TSYP14Challenges/RASxAESSxChallenge/computer_vision/README.md

# Computer vision

**Owner:** Bacha
**Status:** not started

Camera images in, `(event_type, event_value)` out. The Writer puts that pair
in the EVENT_BEACON it drops (see
[`docs/protocol/frame-format.md`](../docs/protocol/frame-format.md)).
