TSYP14Challenges/RASxAESSxChallenge/mechanical-design/3D/design-files/README.md

# Design files

Editable CAD sources (.f3d, .step, .FCStd, .sldprt, …). Export print-ready
files to [`../print-files/`](../print-files/) with the same base name.
