TSYP14Challenges/RASxAESSxChallenge/docs/report/sections/06-robots-hardware.tex

% Owners: Bacha (tank approach, 2FW drive), Hachicha (navigation, BMS and battery)
\section{Robot Hardware}
\todo{components of each robot}
