TSYP14Challenges/RASxAESSxChallenge/docs/report/sections/08-frame-translation.tex

% Owner: Bacha
\section{Frame Translation}\label{sec:frame-translation}
\todo{coordinate system (encoders and SLAM), origin at the PEB, math}
