TSYP14Challenges/RASxAESSxChallenge/docs/report/sections/12-implementation.tex

% Owner: Bacha
\section{Implementation Plan}
\todo{scrum, sprints (add LEDs for beacons)}
