TSYP14Challenges/RASxAESSxChallenge/docs/report/sections/07-navigation.tex

% Owners: Hachicha (writer navigation, executor entry and navigation), Bacha (event detection, executor types, mission decision)
\section{Navigation}
\subsection{Writer}
\todo{navigation (LiDAR, ...) --- Hachicha}

\todo{event detection (hardware, types) --- Bacha}
\subsection{Executor}
\todo{types of executors and how each solves an event --- Bacha}

\todo{mission decision --- Bacha}

\todo{entry and navigation: follows beacon drop order, and why --- Hachicha}
