TSYP14Challenges/RASxAESSxChallenge/mechanical-design/3D/design-files/Assembly/robot assembly 1.SLDASM

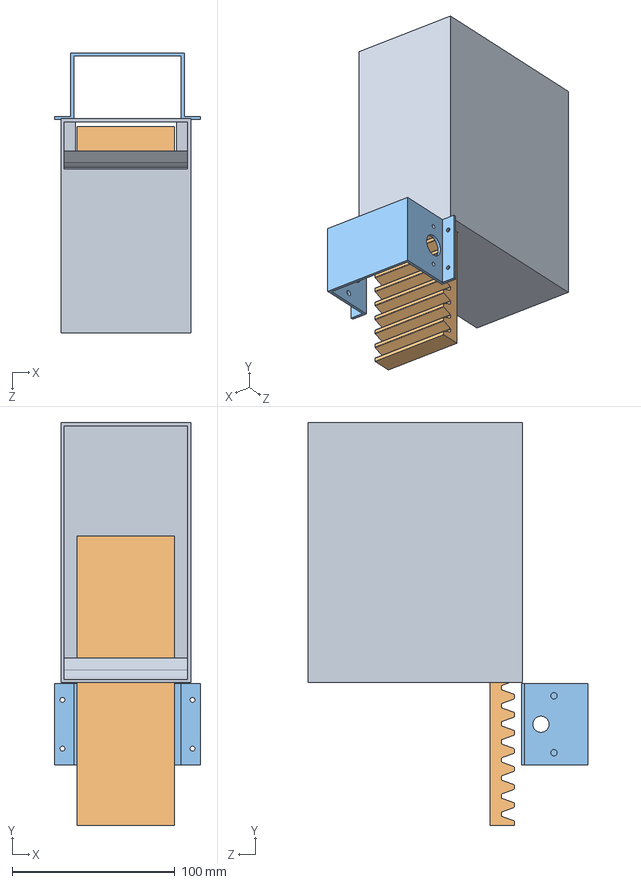
[picture p2: CAD file, 2026-10-05]
mechanical-design/3D/design-files/Assembly/robot assembly 1.SLDASM
90.0 x 247.9 x 172.4 mm
support stepper
Racks
beacons stack
