TSYP14Challenges/RASxAESSxChallenge/mechanical-design/3D/print-files/Parts/robot_main_body.STL

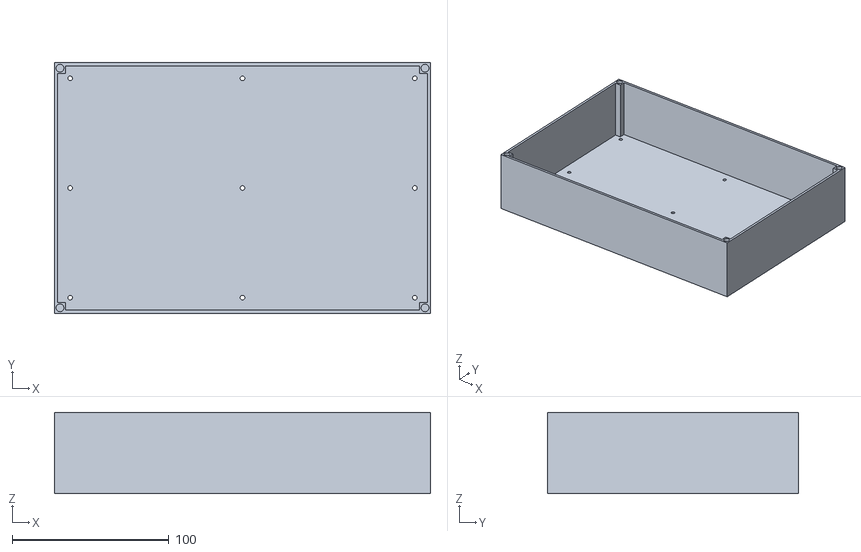
[picture p3: CAD file, 2026-10-05]
mechanical-design/3D/print-files/Parts/robot_main_body.STL
240.0 x 160.0 x 52.0
