TSYP14Challenges/RASxAESSxChallenge/mechanical-design/3D/design-files/Assembly/robot assembly 2.SLDASM

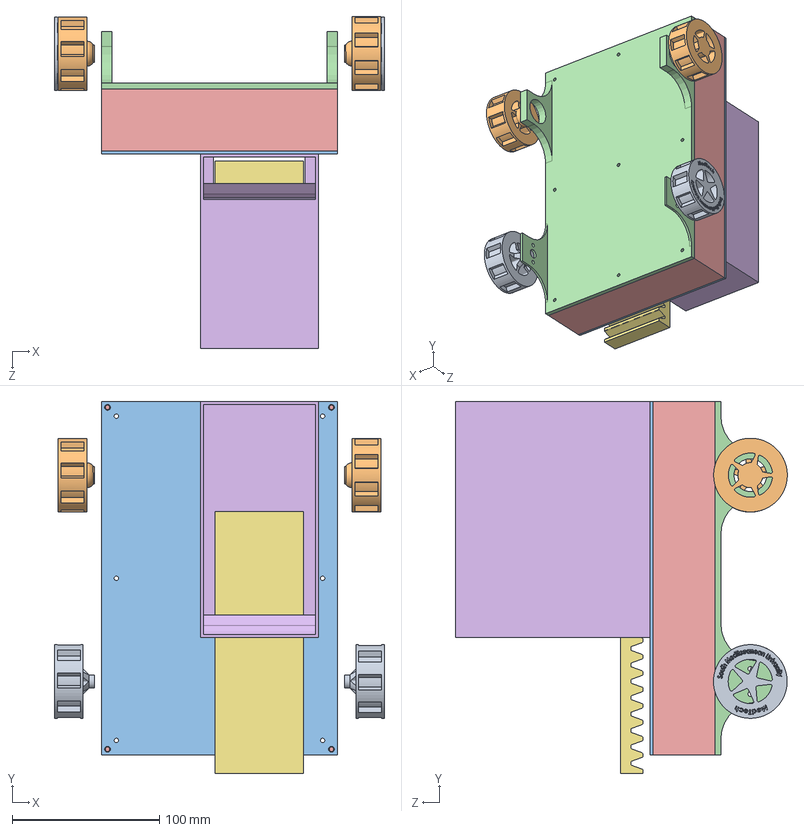
[picture p4: CAD file, 2026-10-05]
mechanical-design/3D/design-files/Assembly/robot assembly 2.SLDASM
224.0 x 252.5 x 225.1 mm
support stepper
Racks
beacons stack
robot level1 base
robot_base
robot level1 cover
Wheel_axe x 2
Wheel x 2
