TSYP14Challenges/RASxAESSxChallenge/mechanical-design/3D/design-files/Parts/robot level1 cover.SLDPRT

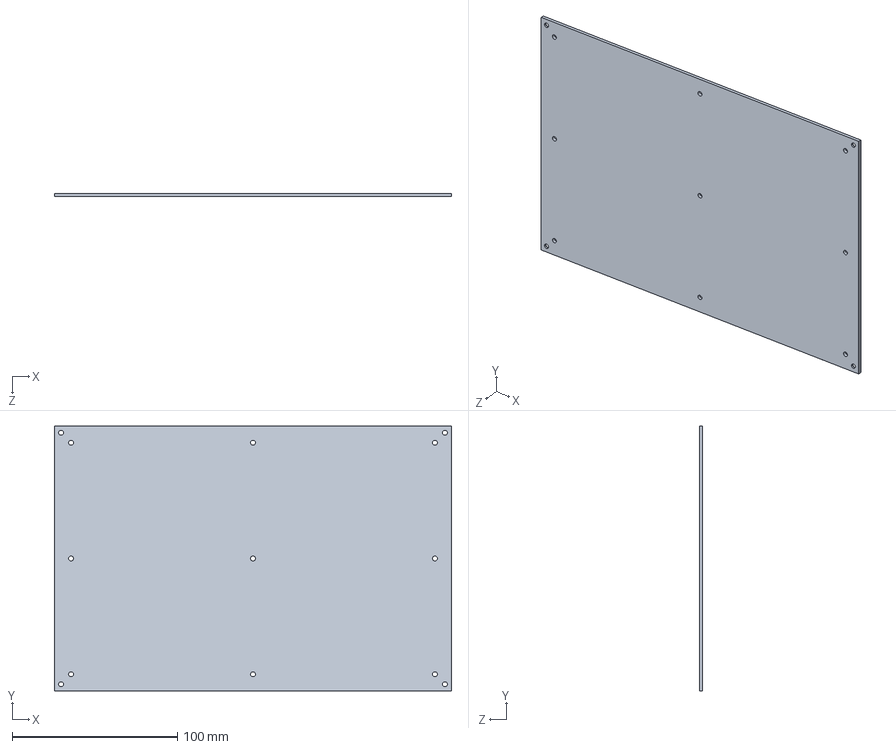
[picture p5: CAD file, 2026-10-05]
mechanical-design/3D/design-files/Parts/robot level1 cover.SLDPRT
240.0 x 160.0 x 2.00 mm
