TSYP14Challenges/RASxAESSxChallenge/mechanical-design/3D/print-files/Print Plate/print_plate_with_spport.3mf

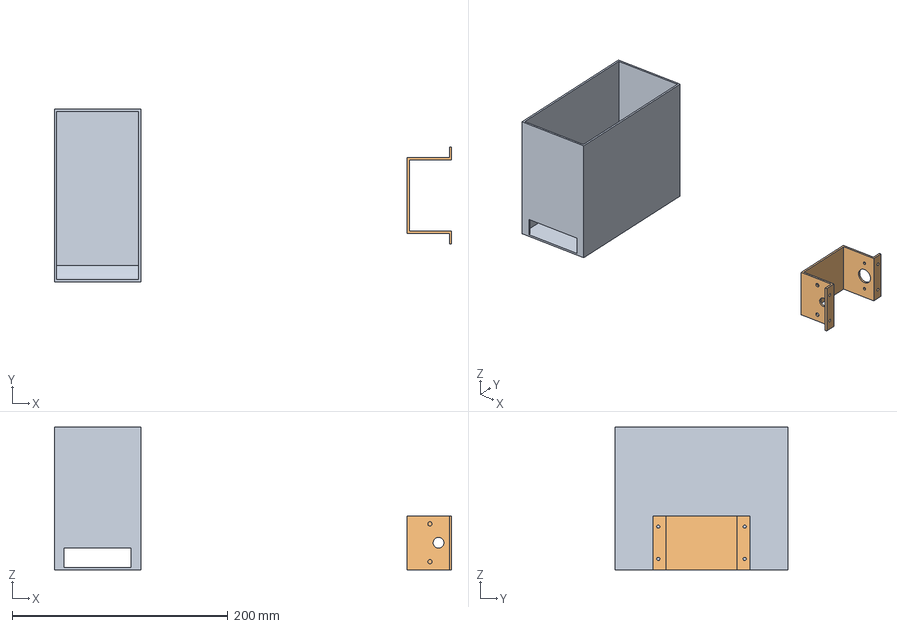
[picture p6: CAD file, 2026-10-05]
mechanical-design/3D/print-files/Print Plate/print_plate_with_spport.3mf
367.7 x 160.0 x 132.0 mm
beacons stack.STL
support stepper.STL
