TSYP14Challenges/RASxAESSxChallenge/mechanical-design/3D/design-files/Parts/back wheels axe.SLDPRT

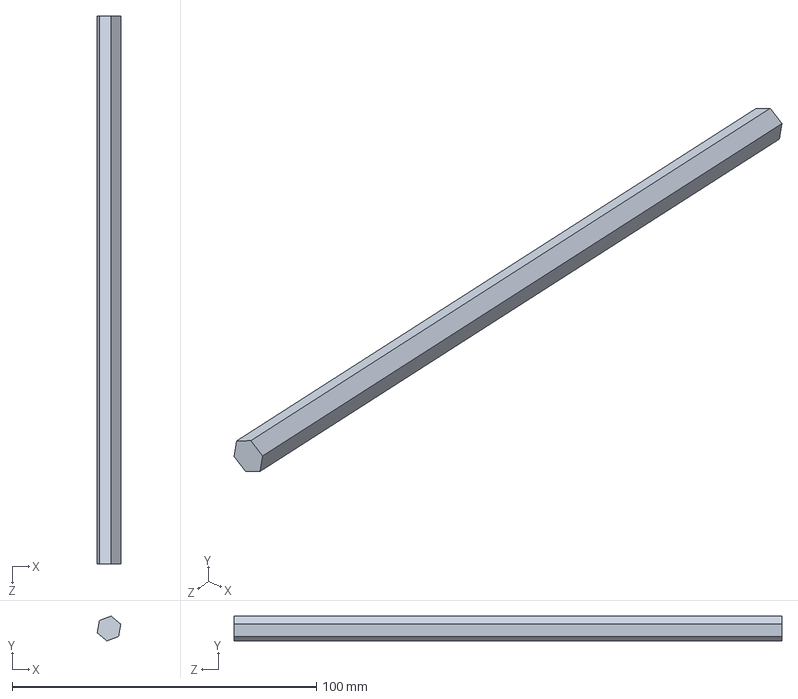
[picture p7: CAD file, 2026-10-05]
mechanical-design/3D/design-files/Parts/back wheels axe.SLDPRT
7.74 x 8.14 x 180.0 mm
