TSYP14Challenges/RASxAESSxChallenge/mechanical-design/3D/print-files/Print Plate/print_plate_without_spport.3mf

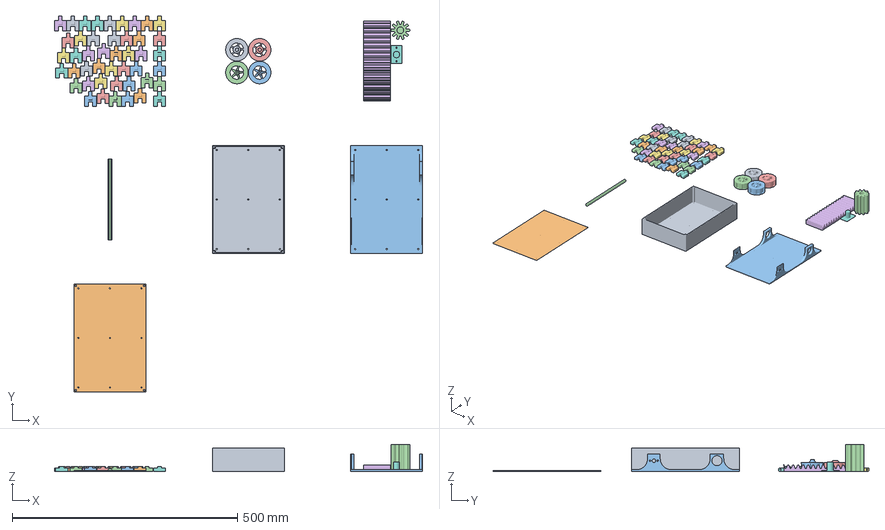
[picture p8: CAD file, 2026-10-05]
mechanical-design/3D/print-files/Print Plate/print_plate_without_spport.3mf
817.9 x 834.6 x 60.0 mm
robot_main_body.STL
robot level1 cover.STL
robot_base.STL
GEAR 2.STL
Wheel_axe.STL x 2
Racks.STL
chenille.stl x 45
axe for gear.STL
Wheel.STL x 2
axe wheels.STL
