TSYP14Challenges/RASxAESSxChallenge/mechanical-design/3D/design-files/Parts/axe for gear.SLDPRT

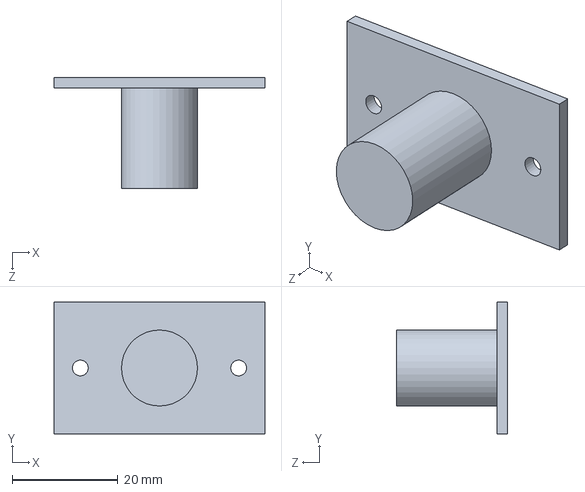
[picture p9: CAD file, 2026-10-05]
mechanical-design/3D/design-files/Parts/axe for gear.SLDPRT
40.0 x 25.0 x 21.0 mm
