TSYP14Challenges/RASxAESSxChallenge/mechanical-design/3D/print-files/Parts/Wheel.STL

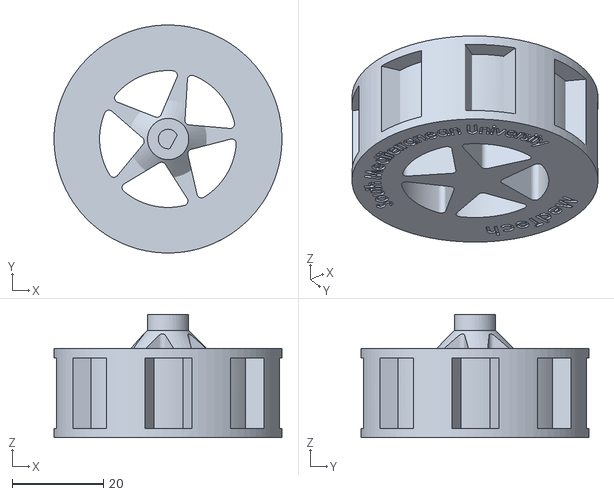
[picture p10: CAD file, 2026-10-05]
mechanical-design/3D/print-files/Parts/Wheel.STL
50.0 x 50.0 x 27.0
