TSYP14Challenges/RASxAESSxChallenge/mechanical-design/3D/design-files/Parts/support stepper.SLDPRT

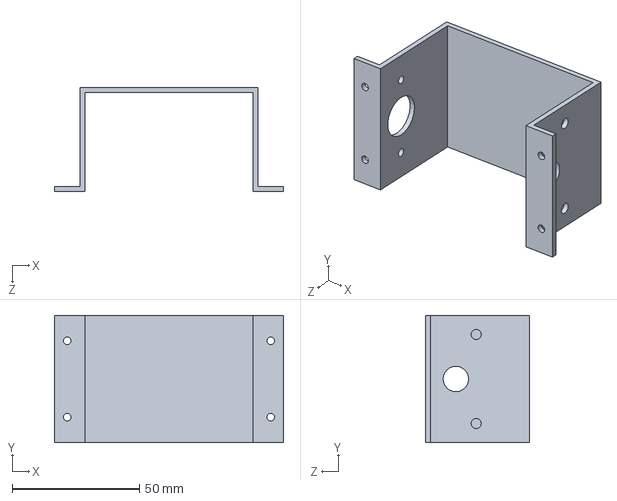
[picture p11: CAD file, 2026-10-05]
mechanical-design/3D/design-files/Parts/support stepper.SLDPRT
90.0 x 50.0 x 41.0 mm
