TSYP14Challenges/RASxAESSxChallenge/mechanical-design/3D/print-files/Parts/beacon example size.STL

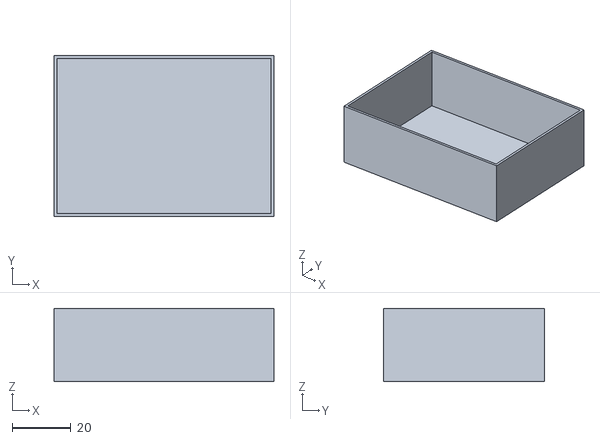
[picture p12: CAD file, 2026-10-05]
mechanical-design/3D/print-files/Parts/beacon example size.STL
75.0 x 55.0 x 25.0
