TSYP14Challenges/RASxAESSxChallenge/mechanical-design/3D/design-files/Parts/robot level1 base.SLDPRT

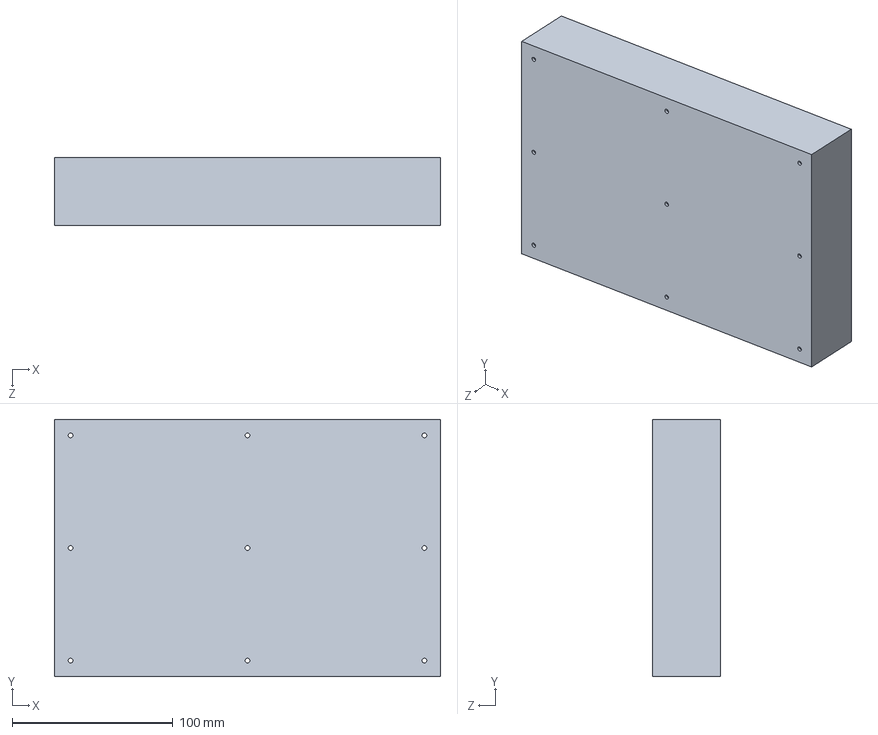
[picture p13: CAD file, 2026-10-05]
mechanical-design/3D/design-files/Parts/robot level1 base.SLDPRT
240.0 x 160.0 x 42.0 mm
