TSYP14Challenges/RASxAESSxChallenge/mechanical-design/3D/print-files/Parts/chenille.stl

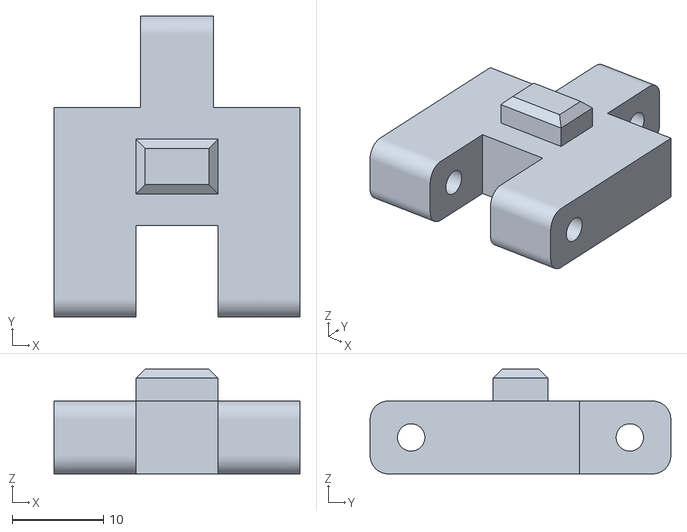
[picture p14: CAD file, 2026-10-05]
mechanical-design/3D/print-files/Parts/chenille.stl
27.0 x 33.0 x 11.5
