TSYP14Challenges/RASxAESSxChallenge/mechanical-design/3D/design-files/Parts/beacons stack.SLDPRT

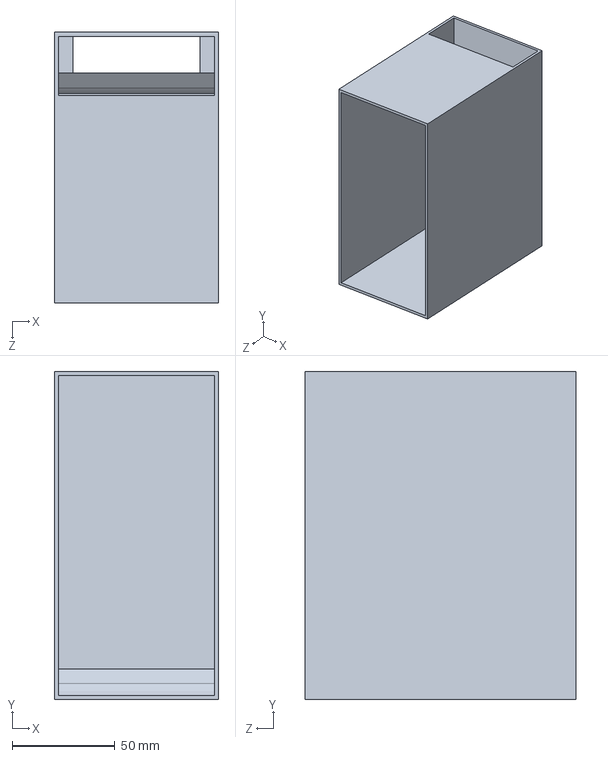
[picture p15: CAD file, 2026-10-05]
mechanical-design/3D/design-files/Parts/beacons stack.SLDPRT
80.0 x 160.0 x 132.0 mm
