TSYP14Challenges/RASxAESSxChallenge/mechanical-design/3D/design-files/Parts/Racks.SLDPRT

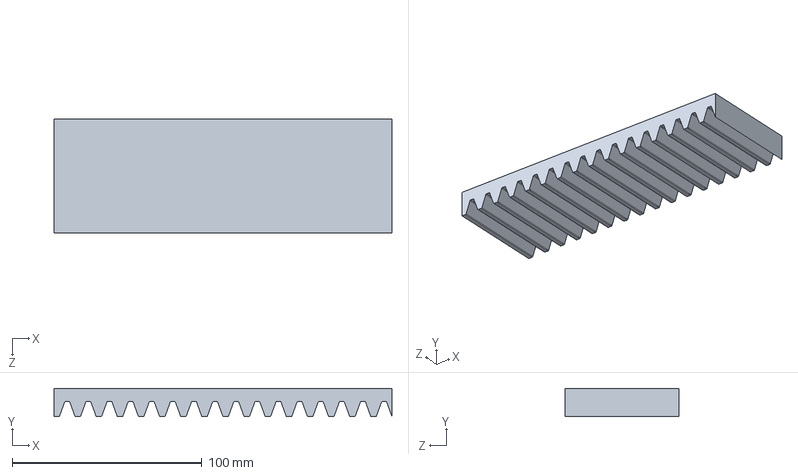
[picture p16: CAD file, 2026-10-05]
mechanical-design/3D/design-files/Parts/Racks.SLDPRT
178.0 x 15.0 x 60.0 mm
