TSYP14Challenges/RASxAESSxChallenge/mechanical-design/3D/design-files/Parts/Wheel_axe.SLDPRT

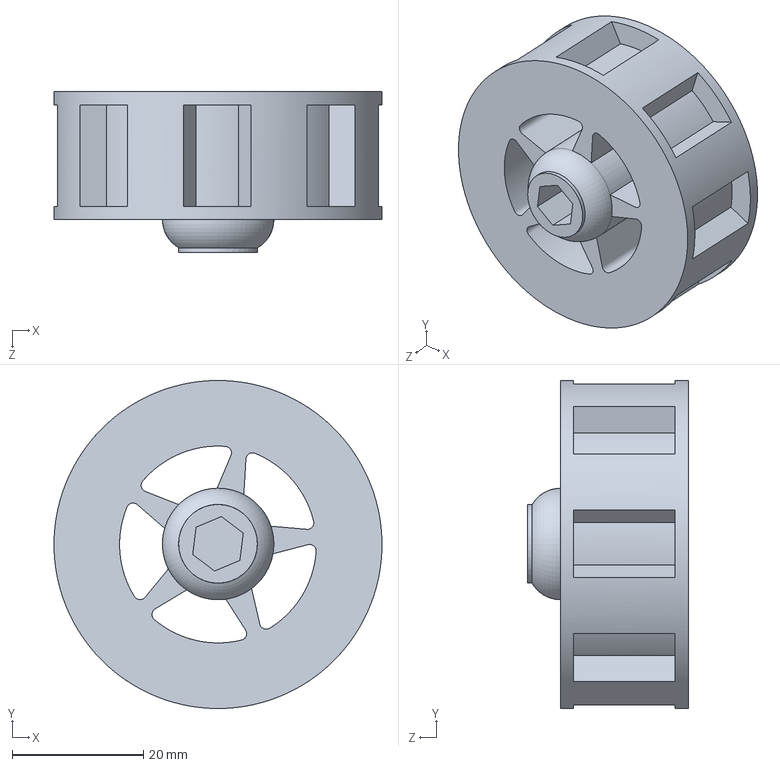
[picture p17: CAD file, 2026-10-05]
mechanical-design/3D/design-files/Parts/Wheel_axe.SLDPRT
50.0 x 50.0 x 24.5 mm
