TSYP14Challenges/RASxAESSxChallenge/mechanical-design/3D/print-files/Parts/GEAR 2.STL

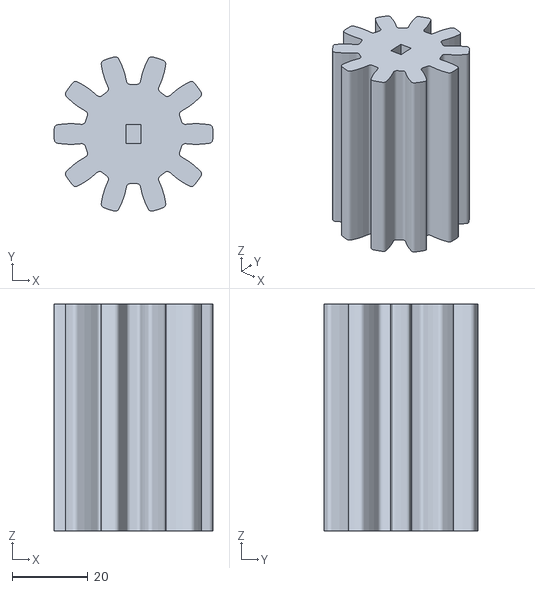
[picture p18: CAD file, 2026-10-05]
mechanical-design/3D/print-files/Parts/GEAR 2.STL
42.0 x 40.8 x 60.0
