TSYP14Challenges/RASxAESSxChallenge/mechanical-design/3D/design-files/Parts/robot_base.SLDPRT

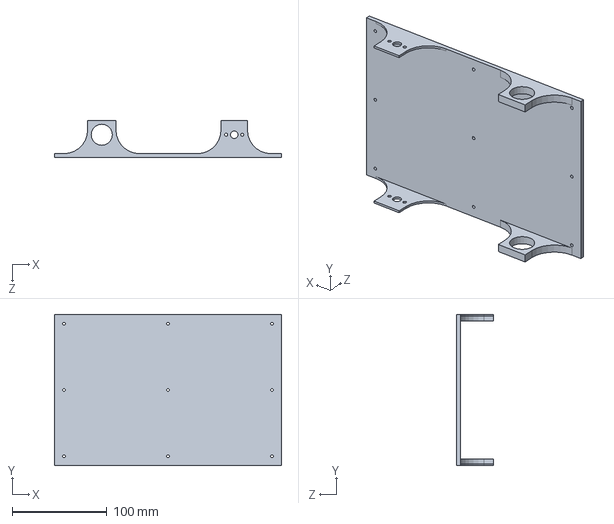
[picture p19: CAD file, 2026-10-05]
mechanical-design/3D/design-files/Parts/robot_base.SLDPRT
240.0 x 160.0 x 39.0 mm
