TSYP14Challenges/RASxAESSxChallenge/(list of files, cad)

Other CAD files:
mechanical-design/3D/print-files/Parts/robot level1 cover.STL
mechanical-design/3D/print-files/Parts/axe wheels.STL
mechanical-design/3D/print-files/Parts/Racks.STL
mechanical-design/3D/design-files/Parts/gear_beacon_deposit.SLDPRT
mechanical-design/3D/print-files/Parts/support stepper.STL
mechanical-design/3D/design-files/Parts/chenille.SLDPRT
mechanical-design/3D/print-files/Parts/beacons stack.STL
mechanical-design/3D/design-files/Parts/Wheel.SLDPRT
mechanical-design/3D/print-files/Parts/Wheel_axe.STL
mechanical-design/3D/print-files/Parts/robot_base.STL
mechanical-design/3D/print-files/Parts/axe for gear.STL
