TSYP14Challenges/RASxAESSxChallenge/mechanical-design/3D/print-files/README.md

# Print files

Print-ready exports (.stl, .3mf) and slicer output (.gcode). Each one must
have its source in [`../design-files/`](../design-files/) with the same base
name.
